Tamar21513/AirHockey-Robot/docs/README.md

# Documentation

- [project-book.pdf](project-book.pdf) – full project book (Hebrew)
- `images/` – photos and diagrams
- `notes/` – development notes for each version

## Images

### Table, top view from the camera

Table top view

### Wiring diagram

Wiring diagram
